marco123445/ESP-ONE/TEILELISTE.md

# ESP-ONE – Parts List / Teileliste

**[English](#english) · [Deutsch](#deutsch)**

---

## English

Parts per speaker.

| # | Group | Part | Qty | Note |
|---|---|---|---|---|
| 1 | Electronics | Sonocotta Louder ESP32 – option "[b] ESP32-WROVER-N8R8 + ext. antenna" | 1 | Not the S3 version, not the "Loud ESP32" |
| 2 | Electronics | Mean Well GST60A18-P1J (18 V / 3.33 A, 5.5/2.1 mm plug) | 1 | |
| 3 | Electronics | DC panel jack DC-099, 5.5 × 2.1 mm, with nut | 1 | |
| 4 | Electronics | Wi-Fi antenna 2.4 GHz, IPEX/U.FL | 1 | Only if none is included with the board |
| 5 | Drivers | Visaton W 100 S – 4 Ω, art. 9020 | 1 | Must be the 4 Ω version (9020)! 9021 = 8 Ω |
| 6 | Drivers | Visaton G 25 NDWG – 8 Ω, art. 1188 | 1 | |
| 7 | Drivers | 4" passive radiator (e.g. GHXAMP), frame 105 mm, cut-out 95 mm, height 31 mm | 1 | Often sold as a 2-pack. Measure after delivery: weight + deflection under 50 g |
| 8 | Drivers | MKP film capacitor 22 µF, ≥ 100 V | 1 | Tweeter protection, in series in the plus lead |
| 9 | Damping | Butyl damping mat 2 mm, self-adhesive | approx. 0.07 m² | |
| 10 | Damping | Polyester damping wool for speakers | approx. 30 g | |
| 11 | Sealing | EVA foam gasket tape, single-sided adhesive, 2 mm thick × 5 mm wide | 1 m | Back panel joint |
| 12 | Sealing | EVA foam gasket tape, single-sided adhesive, 1 mm thick × 5 mm wide | 1 m | Woofer and radiator flanges; cut to approx. 3 mm for the tweeter |
| 13 | Hardware | Rubber feet 12.7 × 3.5 mm, self-adhesive | 4 | |
| 14 | Wiring | Speaker cable 2 × 0.75 mm² OFC (pure copper, not CCA) | 1 m | |
| 15 | Wiring | Silicone wire 20 AWG red/black | 1 m | |
| 16 | Wiring | Heat-shrink tubing set | 1 | |
| 17 | Filament | PLA (e.g. Bambu PLA Basic) or PETG (e.g. Bambu PETG HF) | approx. 0.7 kg | + 80 g for the test-fit piece; 1 roll per speaker |
| 18 | Hardware | Steel washers (added mass for the passive radiator) | 4–6 | Quantity depends on the measurement |
| 19 | Hardware | Heat-set inserts M3 × L5 × OD4.5 (bore 4.0 mm) | 26 | 6 back panel · 5 woofer · 4 tweeter · 4 radiator · 3 PCB · 4 grille |
| 20 | Hardware | Socket head screws M3: 6 × 10 mm · 9 × 12 mm · 8 × 8 mm · 3 × 6 mm | 26 | M3×10 back panel · M3×12: 5 woofer + 4 grille · M3×8: 4 tweeter + 4 radiator · M3×6 PCB |

**Also needed:** IEC C13 power cord for the power supply, solder.

**Tools:** soldering iron (also for the heat-set inserts), 2.5 mm hex key, small screwdriver, multimeter, calipers, kitchen scale.

---

## Deutsch

Teile pro Lautsprecher.

| # | Gruppe | Teil | Menge | Hinweis |
|---|---|---|---|---|
| 1 | Elektronik | Sonocotta Louder ESP32 – Option "[b] ESP32-WROVER-N8R8 + ext. antenna" | 1 | Nicht die S3-Version, nicht das "Loud ESP32" |
| 2 | Elektronik | Mean Well GST60A18-P1J (18 V / 3,33 A, Stecker 5,5/2,1 mm) | 1 | |
| 3 | Elektronik | DC-Einbaubuchse DC-099, 5,5 × 2,1 mm, mit Mutter | 1 | |
| 4 | Elektronik | WLAN-Antenne 2,4 GHz, IPEX/U.FL | 1 | Nur falls beim Board keine dabei ist |
| 5 | Lautsprecher | Visaton W 100 S – 4 Ω, Art. 9020 | 1 | Unbedingt die 4-Ω-Version (9020)! 9021 = 8 Ω |
| 6 | Lautsprecher | Visaton G 25 NDWG – 8 Ω, Art. 1188 | 1 | |
| 7 | Lautsprecher | 4"-Passivmembran (z.B. GHXAMP), Rahmen 105 mm, Ausschnitt 95 mm, Höhe 31 mm | 1 | Oft im 2er-Pack. Nach Erhalt messen: Gewicht + Einsenkung unter 50 g |
| 8 | Lautsprecher | MKP-Folienkondensator 22 µF, ≥ 100 V | 1 | Schutz für den Hochtöner, in Serie in die Plus-Leitung |
| 9 | Dämmung | Alubutyl-Dämmmatte 2 mm, selbstklebend | ca. 0,07 m² | |
| 10 | Dämmung | Polyester-Dämmwolle für Lautsprecher | ca. 30 g | |
| 11 | Dichtung | EVA-/Moosgummi-Dichtband, einseitig klebend, 2 mm dick × 5 mm breit | 1 m | Fuge der Rückwand |
| 12 | Dichtung | EVA-/Moosgummi-Dichtband, einseitig klebend, 1 mm dick × 5 mm breit | 1 m | Flansche von Tieftöner und Membran; für den Hochtöner auf ca. 3 mm zuschneiden |
| 13 | Mechanik | Gummifüsse 12,7 × 3,5 mm, selbstklebend | 4 | |
| 14 | Kabel | Lautsprecherkabel 2 × 0,75 mm² OFC (reines Kupfer, kein CCA) | 1 m | |
| 15 | Kabel | Silikonlitze 20 AWG rot/schwarz | 1 m | |
| 16 | Kabel | Schrumpfschlauch-Set | 1 | |
| 17 | Filament | PLA (z.B. Bambu PLA Basic) oder PETG (z.B. Bambu PETG HF) | ca. 0,7 kg | + 80 g für die Passprobe; 1 Rolle pro Lautsprecher |
| 18 | Mechanik | Stahl-Unterlegscheiben (Zusatzmasse für die Passivmembran) | 4–6 | Menge je nach Messung |
| 19 | Mechanik | Gewindeeinsätze M3 × L5 × OD4,5 (Bohrung 4,0 mm) | 26 | 6 Rückwand · 5 Tieftöner · 4 Hochtöner · 4 Membran · 3 Platine · 4 Kappe |
| 20 | Mechanik | Zylinderkopfschrauben M3: 6 × 10 mm · 9 × 12 mm · 8 × 8 mm · 3 × 6 mm | 26 | M3×10 Rückwand · M3×12: 5 Tieftöner + 4 Kappe · M3×8: 4 Hochtöner + 4 Membran · M3×6 Platine |

**Zusätzlich:** Kaltgerätekabel C13 für das Netzteil, Lötzinn.

**Werkzeug:** Lötkolben (auch für die Gewindeeinsätze), Inbus 2,5 mm, kleiner Schraubenzieher, Multimeter, Schieblehre, Küchenwaage.
