marco123445/ESP-ONE/druck/bambu_PETG/ESPONE5_1_Passprobe.3mf

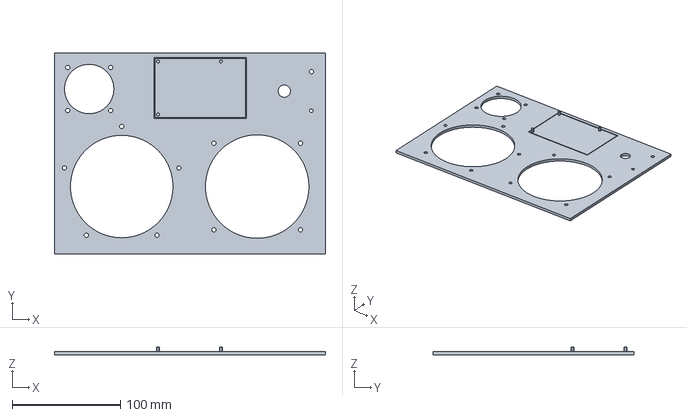
[picture p13: CAD file, 2026-11-01]
druck/bambu_PETG/ESPONE5_1_Passprobe.3mf
250.0 x 185.0 x 7.00 mm
