marco123445/ESP-ONE/druck/bambu_PLA/ESPONE5_PLA_3_Rueckwand.3mf

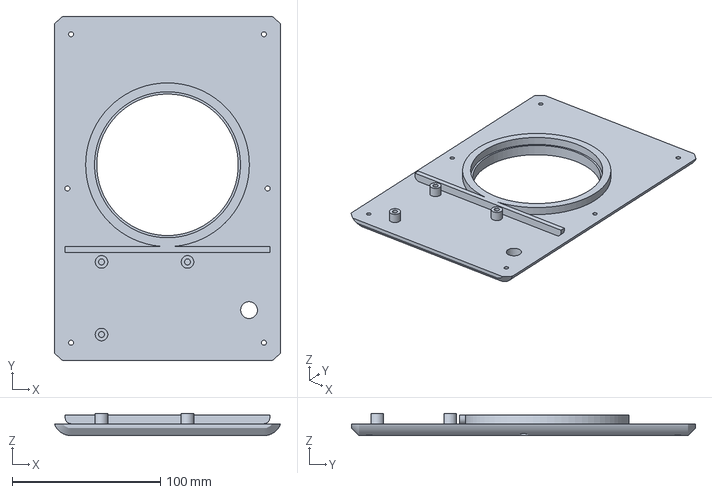
[picture p14: CAD file, 2026-11-01]
druck/bambu_PLA/ESPONE5_PLA_3_Rueckwand.3mf
152.6 x 232.0 x 15.0 mm
