marco123445/ESP-ONE/druck/bambu_PETG/ESPONE5_4_Frontkappe.3mf

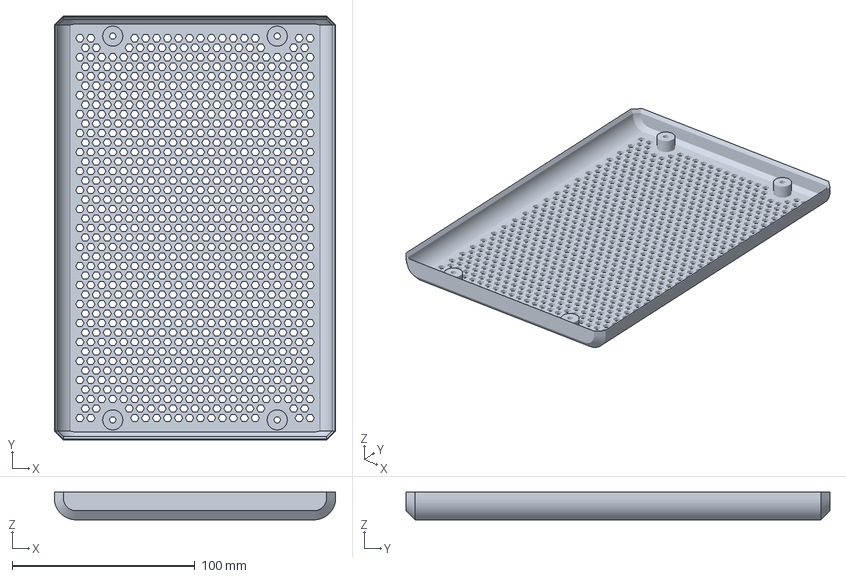
[picture p15: CAD file, 2026-11-01]
druck/bambu_PETG/ESPONE5_4_Frontkappe.3mf
154.0 x 232.0 x 15.2 mm
