marco123445/ESP-ONE/druck/stl/espone5_body.stl

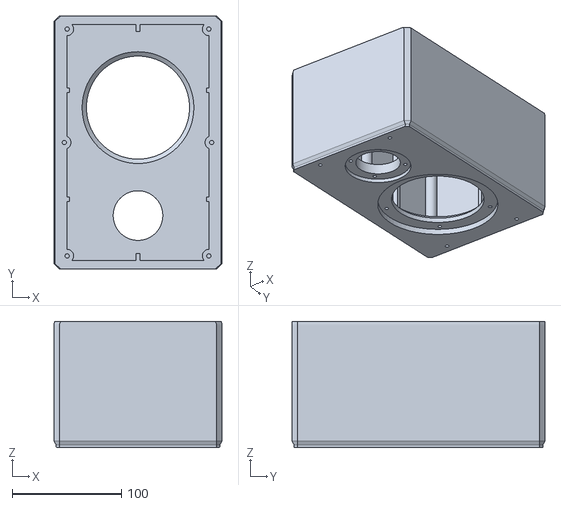
[picture p16: CAD file, 2026-11-01]
druck/stl/espone5_body.stl
154.0 x 232.0 x 116.0
