marco123445/ESP-ONE/(list of files, cad)

Other CAD files:
druck/stl/espone5_back.stl
druck/bambu_PLA/ESPONE5_PLA_1_Passprobe.3mf
druck/bambu_PETG/ESPONE5_2_Korpus.3mf
druck/bambu_PLA/ESPONE5_PLA_2_Korpus.3mf
druck/stl/espone5_cap.stl
druck/bambu_PETG/ESPONE5_3_Rueckwand.3mf
druck/bambu_PLA/ESPONE5_PLA_4_Frontkappe.3mf
druck/stl/espone5_testfit.stl
