marco123445/ESP-ONE/anleitung/pages_en/page_en_08.png

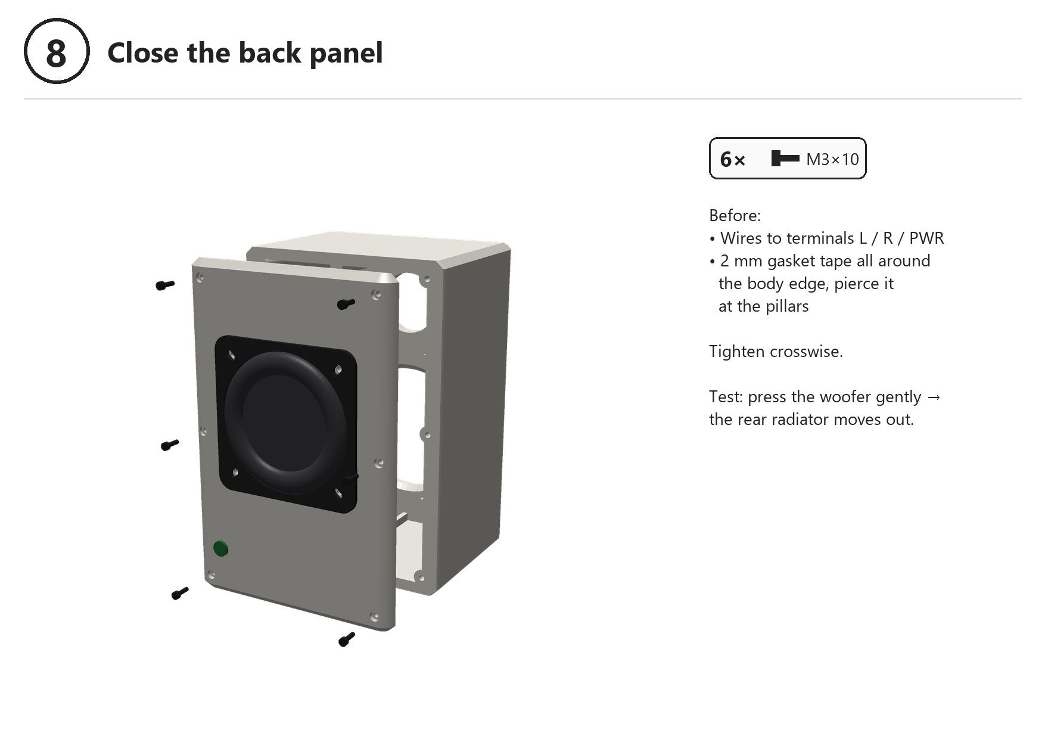
anleitung/pages_en/page_en_08.png
