marco123445/ESP-ONE/anleitung/pages_en/page_en_09.png

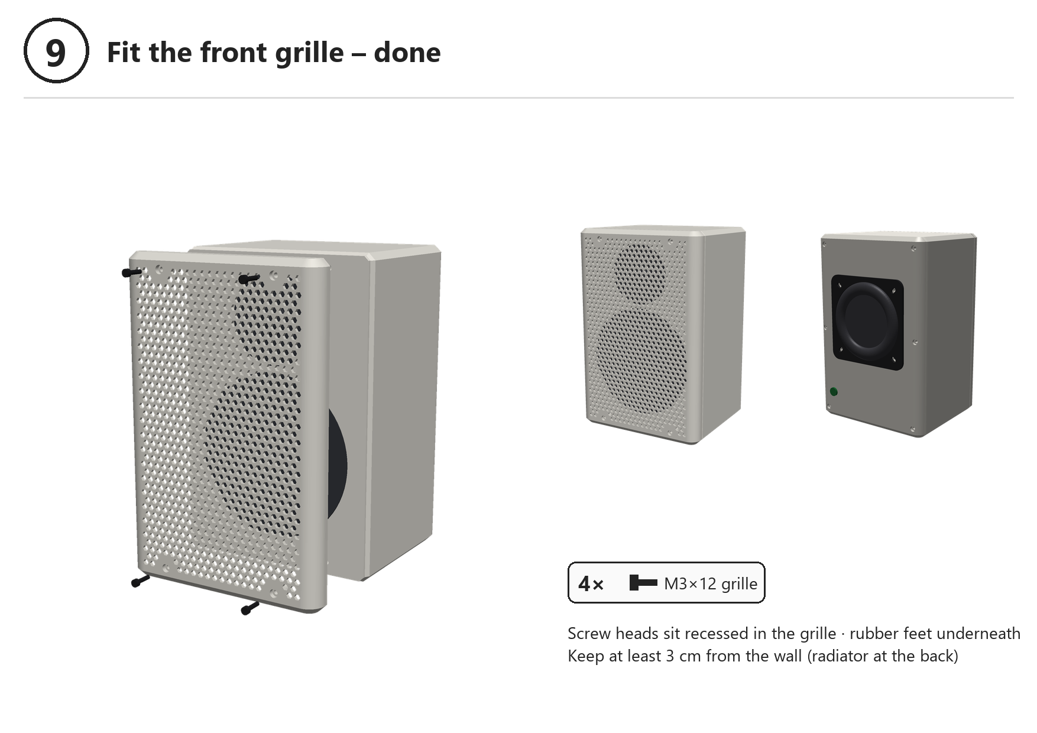
anleitung/pages_en/page_en_09.png
