marco123445/ESP-ONE/anleitung/seiten/seite_00.png

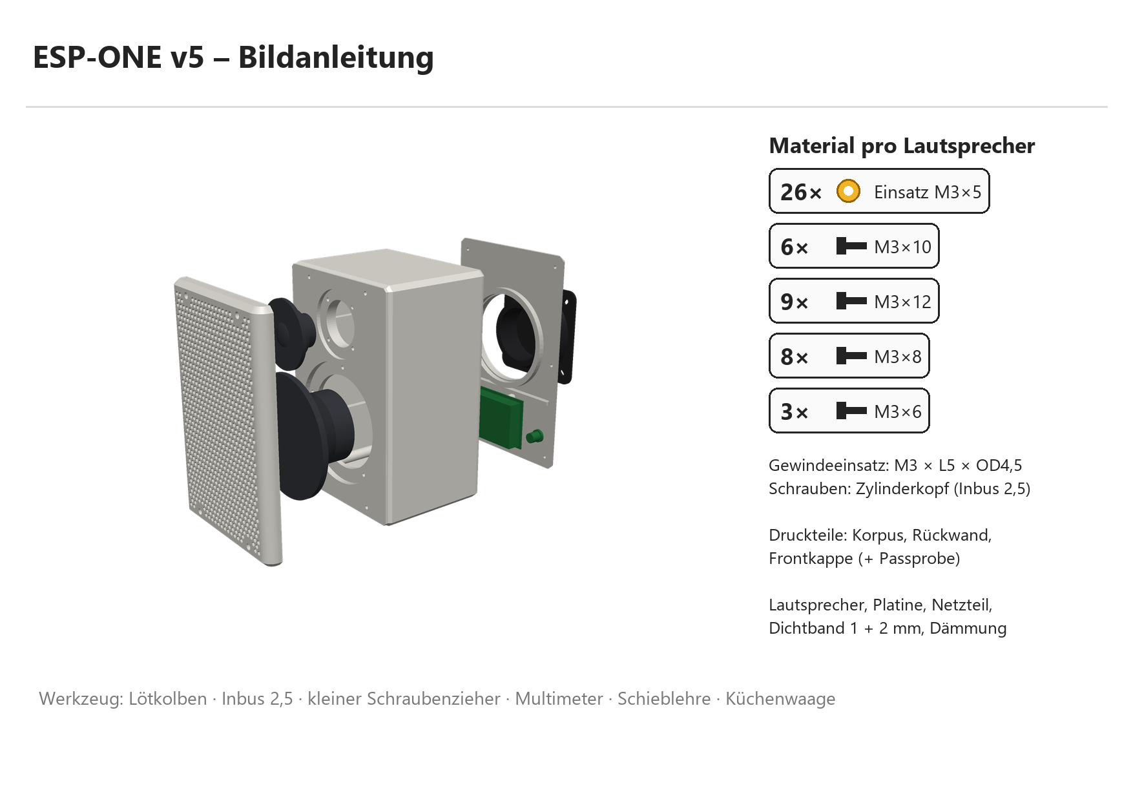
anleitung/seiten/seite_00.png
