marco123445/ESP-ONE/anleitung/seiten/seite_02.png

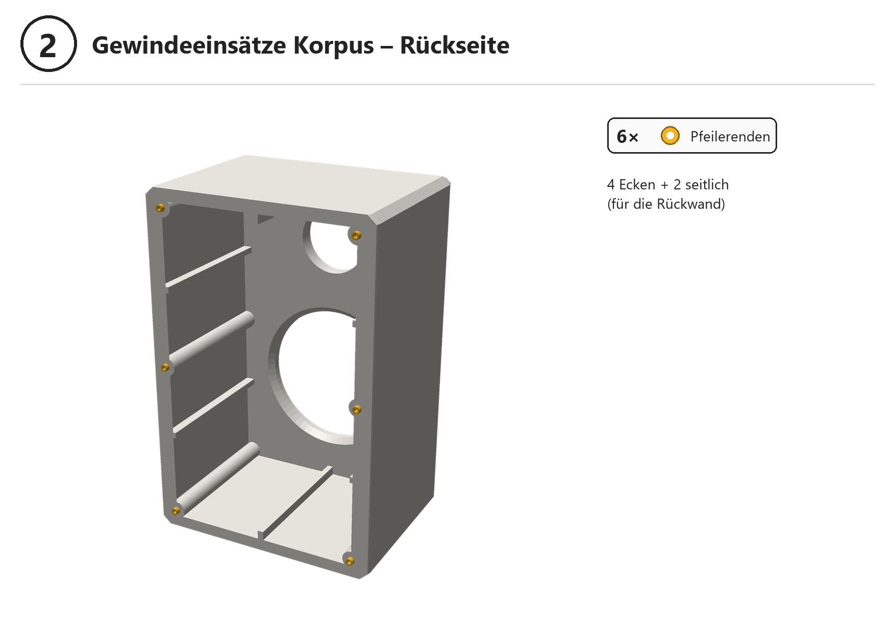
anleitung/seiten/seite_02.png
