marco123445/ESP-ONE/anleitung/seiten/seite_05.png

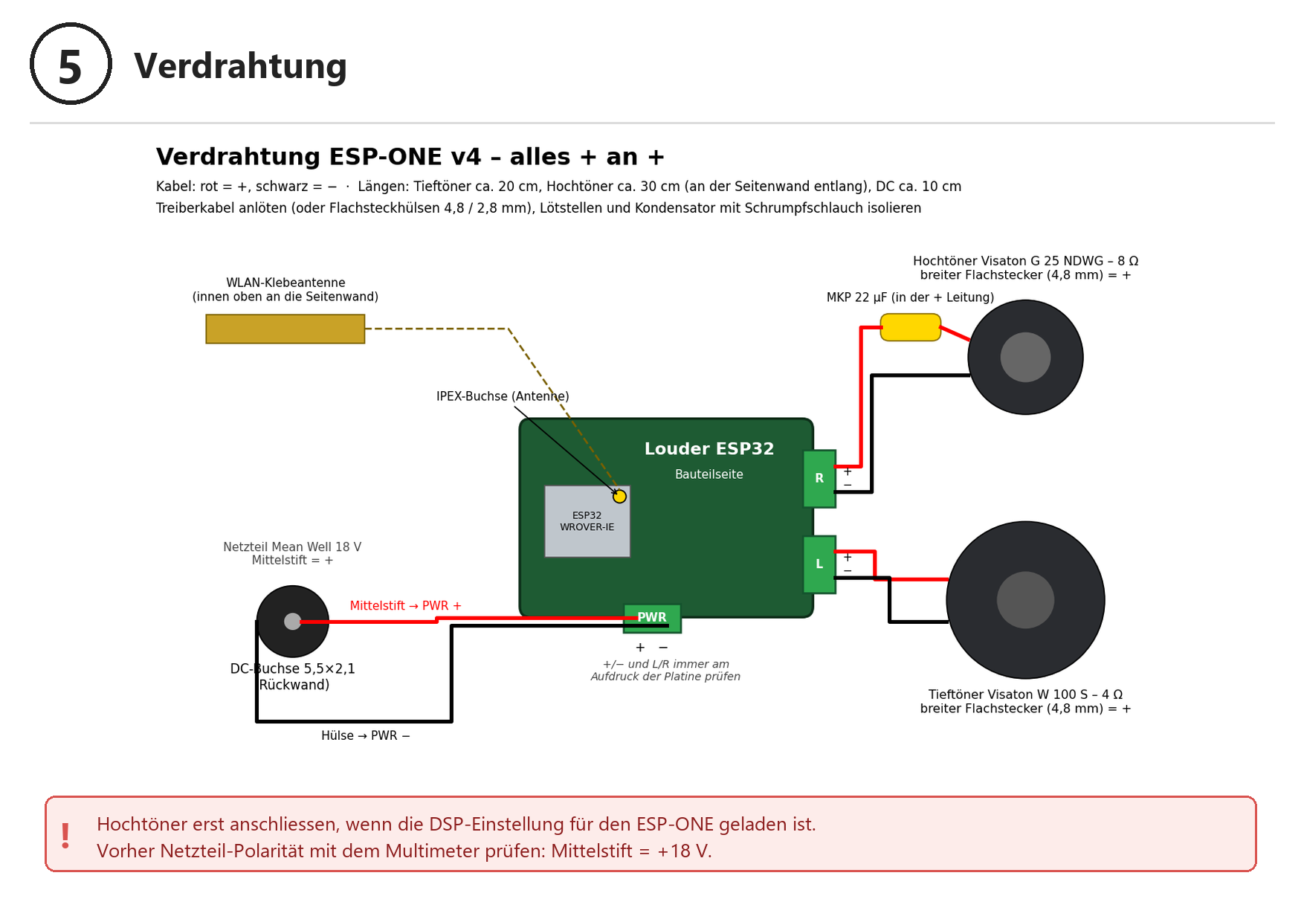
anleitung/seiten/seite_05.png
