marco123445/ESP-ONE/anleitung/seiten/seite_07.png

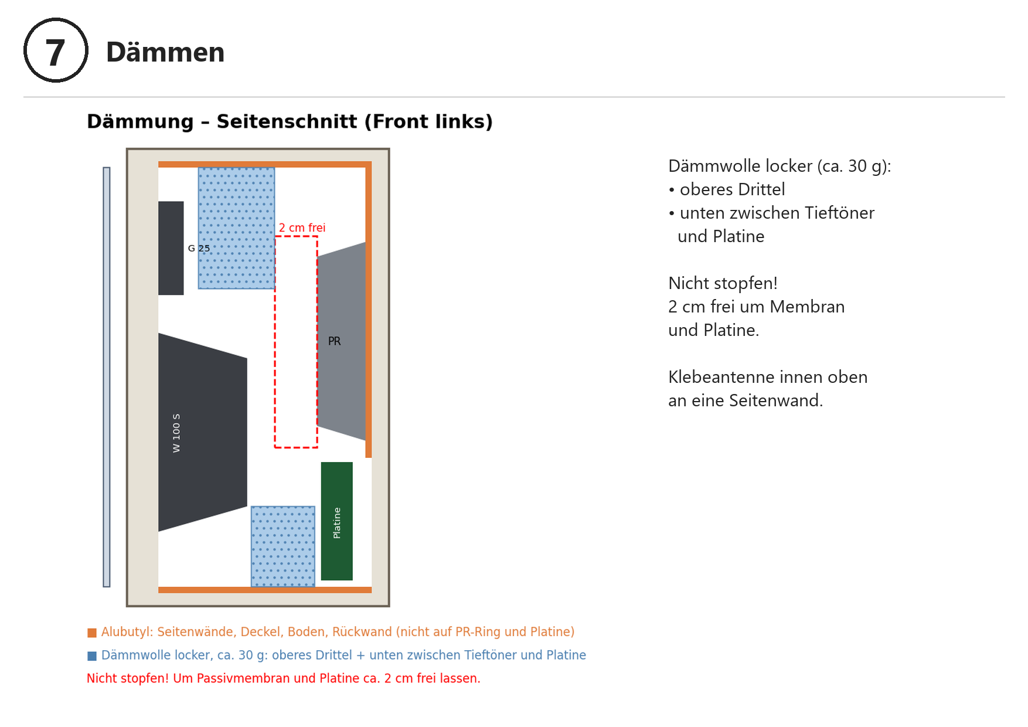
anleitung/seiten/seite_07.png
