marco123445/ESP-ONE/(commit log)

2026-11-01 ESP-ONE v5: CAD, Druckdateien, Bildanleitung und Teileliste
    DIY-WLAN-Lautsprecher (Louder ESP32/TAS5805M, Visaton W 100 S + G 25 NDWG,
    4"-Passivmembran) mit 3D-gedrucktem Gehäuse.
    - OpenSCAD-Modell und Kollisionsprüfung
    - STL und fertig geslicte Bambu-Projekte (P1S, PLA Basic und PETG HF)
    - Bildanleitung (10 Seiten) und Teileliste
    [ESPONE5_1_Passprobe.3mf, ESPONE5_2_Korpus.3mf, ESPONE5_3_Rueckwand.3mf, ESPONE5_4_Frontkappe.3mf, ESPONE5_PLA_1_Passprobe.3mf, ESPONE5_PLA_2_Korpus.3mf, ESPONE5_PLA_3_Rueckwand.3mf, ESPONE5_PLA_4_Frontkappe.3mf]
2026-11-01 Teileliste und Ordnerübersicht zweisprachig, CAD-Kopf Englisch/Deutsch
    [espone.scad, kollisionspruefung.scad]
